NikkoLaw/CAD-KO1/Gewichtsberechnung.docx

Gewichtsberechnung

Gesamtgewciht= 22,383kg (<45kg)
