NikkoLaw/CAD-KO1/INHALTSVERZEICHNIS.docx

INHALTSVERZEICHNIS

Laufzettel

Handentwurf

Kinematik

Kräfteplan mit Kräfteberechnung

Festigkeitsnachweis der angegebenen kritischer Bauteilstellen

Werkstattzeichnung

Einzeilteilzeichnung (Hebel, Gestänge)

Stückliste

Datenblätter
