NikkoLaw/CAD-KO1/DRUCK 5.pdf

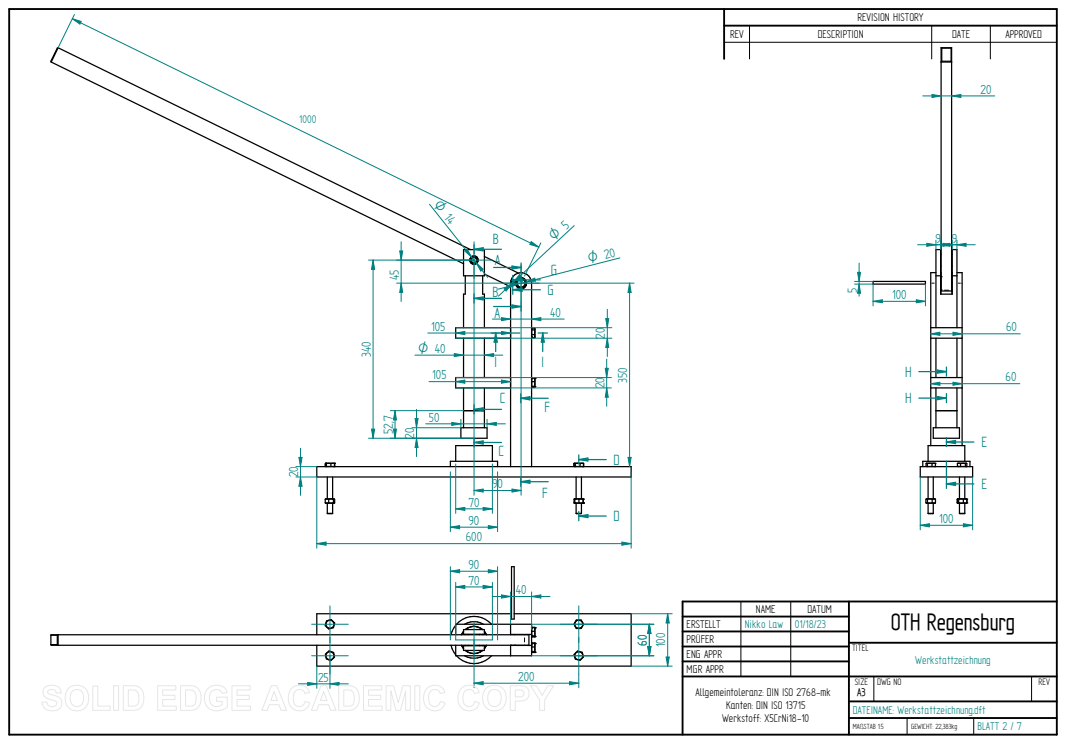
[picture p1: page 1]
TITEL; Werkstattzeichnung; MAßSTAB 1:5; GEWICHT: 22,383kg; BLATT 2 / 7

REVISION HISTORY

REV | DESCRIPTION | DATE | APPROVED

NAME | DATUM | OTH Regensburg

ERSTELLT | Nikko Law | 01/18/23
PRÜFER
ENG APPR
MGR APPR
Allgemeintoleranz: DIN ISO 2768-mk Kanten: DIN ISO 13715 Werkstoff: X5CrNi18-10 | SIZE A3 | DWG NO | REV

DATEINAME: Werkstattzeichnung.dft
