NikkoLaw/CAD-KO1/DRUCK 1.pdf

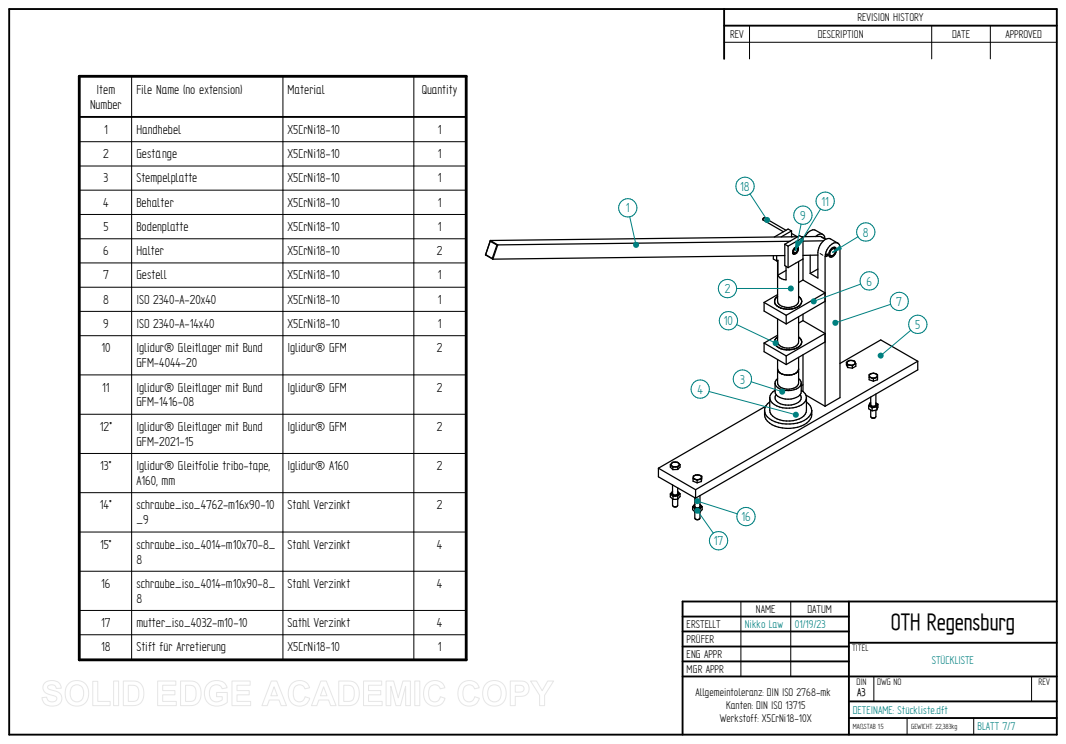
[picture p2: page 1]
TITEL; STÜCKLISTE; MAßSTAB 1:5; GEWICHT: 22,383kg; BLATT 7/7

REVISION HISTORY

REV | DESCRIPTION | DATE | APPROVED

Item Number | File Name (no extension) | Material | Quantity

1 | Handhebel | X5CrNi18-10 | 1
2 | Gestänge | X5CrNi18-10 | 1
3 | Stempelplatte | X5CrNi18-10 | 1
4 | Behalter | X5CrNi18-10 | 1
5 | Bodenplatte | X5CrNi18-10 | 1
6 | Halter | X5CrNi18-10 | 2
7 | Gestell | X5CrNi18-10 | 1
8 | ISO 2340-A-20x40 | X5CrNi18-10 | 1
9 | ISO 2340-A-14x40 | X5CrNi18-10 | 1
10 Iglidur® Gleitlager mit Bund | GFM-4044-20 | Iglidur® GFM | 2

11 Iglidur® Gleitlager mit Bund | GFM-1416-08 | Iglidur® GFM | 2

12* | Iglidur® Gleitlager mit Bund GFM-2021-15 | Iglidur® GFM | 2

13* | Iglidur® Gleitfolie tribo-tape, A160, mm | Iglidur® A160 | 2

14* | schraube_iso_4762-m16x90-10 _9 | Stahl Verzinkt | 2

15* | schraube_iso_4014-m10x70-8_ 8 | Stahl Verzinkt | 4

16 schraube_iso_4014-m10x90-8_ | 8 | Stahl Verzinkt | 4

NAME | DATUM | OTH Regensburg

17 | mutter_iso_4032-m10-10 | Sathl Verzinkt | 4
18 | Stift für Arretierung | X5CrNi18-10 | 1

ERSTELLT | Nikko Law | 01/19/23
PRÜFER
ENG APPR
MGR APPR
Allgemeintoleranz: DIN ISO 2768-mk Kanten: DIN ISO 13715 Werkstoff: X5CrNi18-10X | DIN A3 | DWG NO | REV

DETEINAME: Stückliste.dft
