NikkoLaw/CAD-KO1/DRUCK 2.pdf

40 | 35 12 | 14,51x45v
A

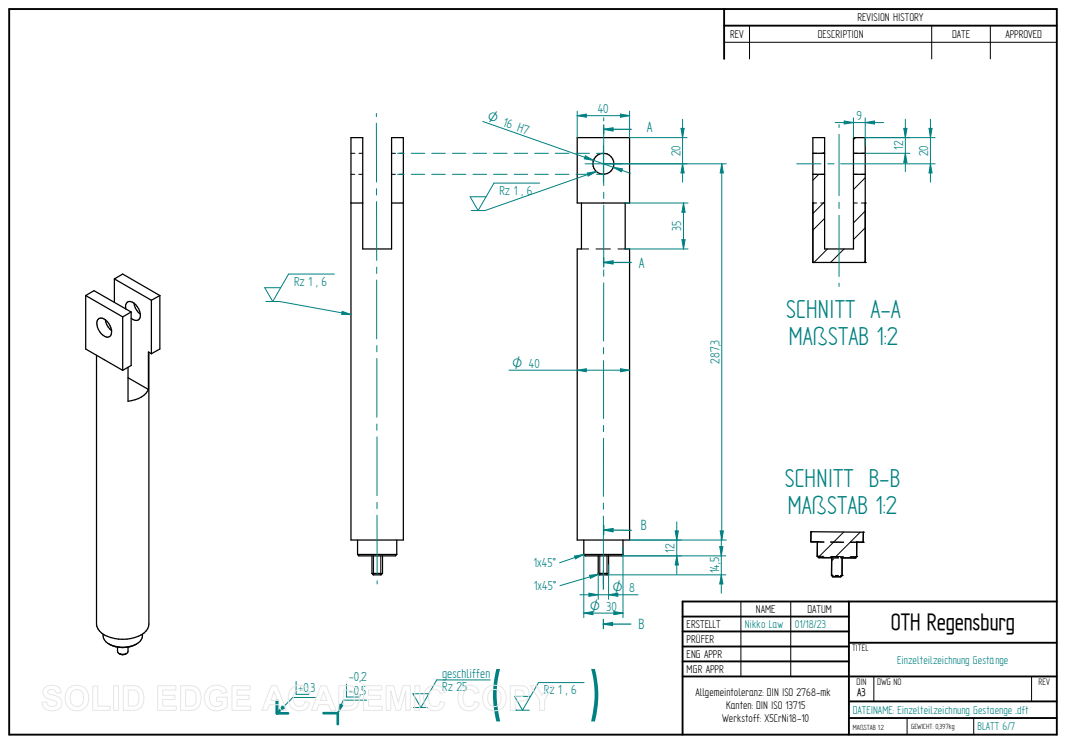
[picture p3: page 1]
TITEL; Einzelteilzeichnung Gestänge; MAßSTAB 1:2; GEWICHT: 0,397kg; BLATT 6/7; SCHNITT A-A MAßSTAB 1:2; SCHNITT B-B; MAßSTAB 1:2 ¹²; geschliffen

REVISION HISTORY

REV | DESCRIPTION | DATE | APPROVED

NAME | DATUM | OTH Regensburg

ERSTELLT | Nikko Law | 01/18/23
PRÜFER
ENG APPR
MGR APPR
Allgemeintoleranz: DIN ISO 2768-mk Kanten: DIN ISO 13715 Werkstoff: X5CrNi18-10 | DIN A3 | DWG NO | REV

DATEINAME: Einzelteilzeichnung Gestaenge .dft
