NikkoLaw/CAD-KO1/DRUCK 3.pdf

# SCHNITT A-A Maßstab 1:1

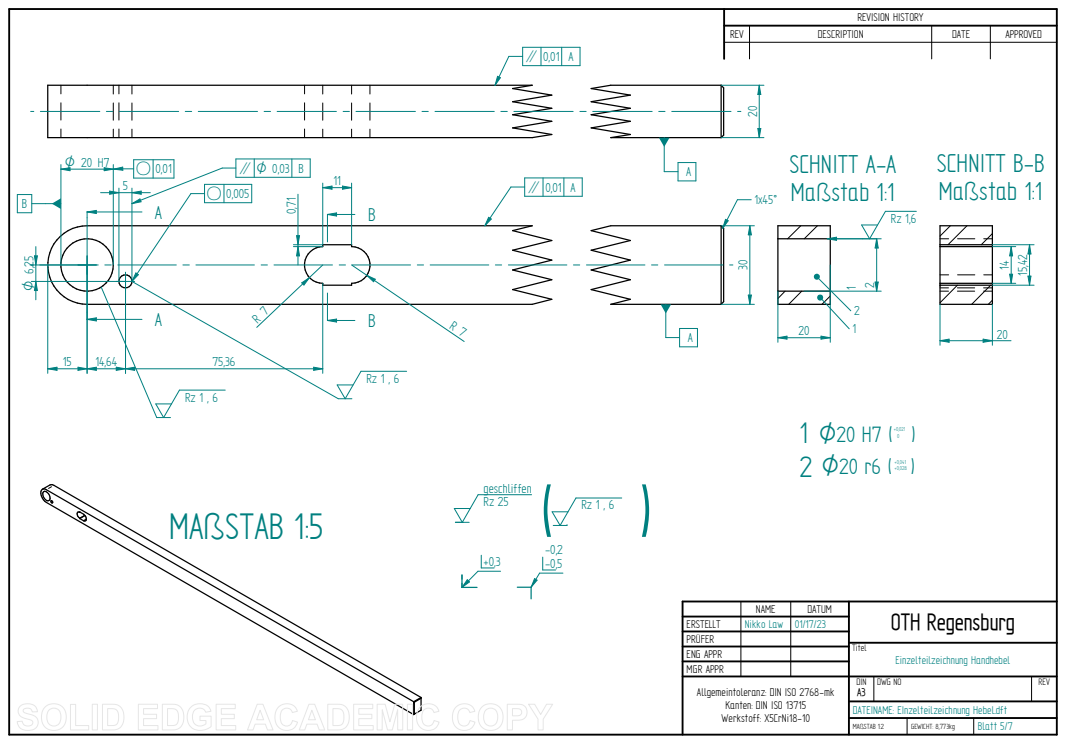
[picture p4: page 1]
Titel; Einzelteilzeichnung Handhebel; MAßSTAB 1:2; GEWICHT: 8,773kg; Blatt 5/7; MAßSTAB 1:5; SCHNITT B-B Maßstab 1:1

REVISION HISTORY

REV | DESCRIPTION | DATE | APPROVED

14,64 | A R 7 75,36 | geschliffen

NAME | DATUM | OTH Regensburg

ERSTELLT | Nikko Law | 01/17/23
PRÜFER
ENG APPR
MGR APPR
Allgemeintoleranz: DIN ISO 2768-mk Kanten: DIN ISO 13715 Werkstoff: X5CrNi18-10 | DIN A3 | DWG NO | REV

DATEINAME: EInzelteilzeichnung Hebel.dft
