NikkoLaw/CAD-KO1/DRUCK 4.pdf

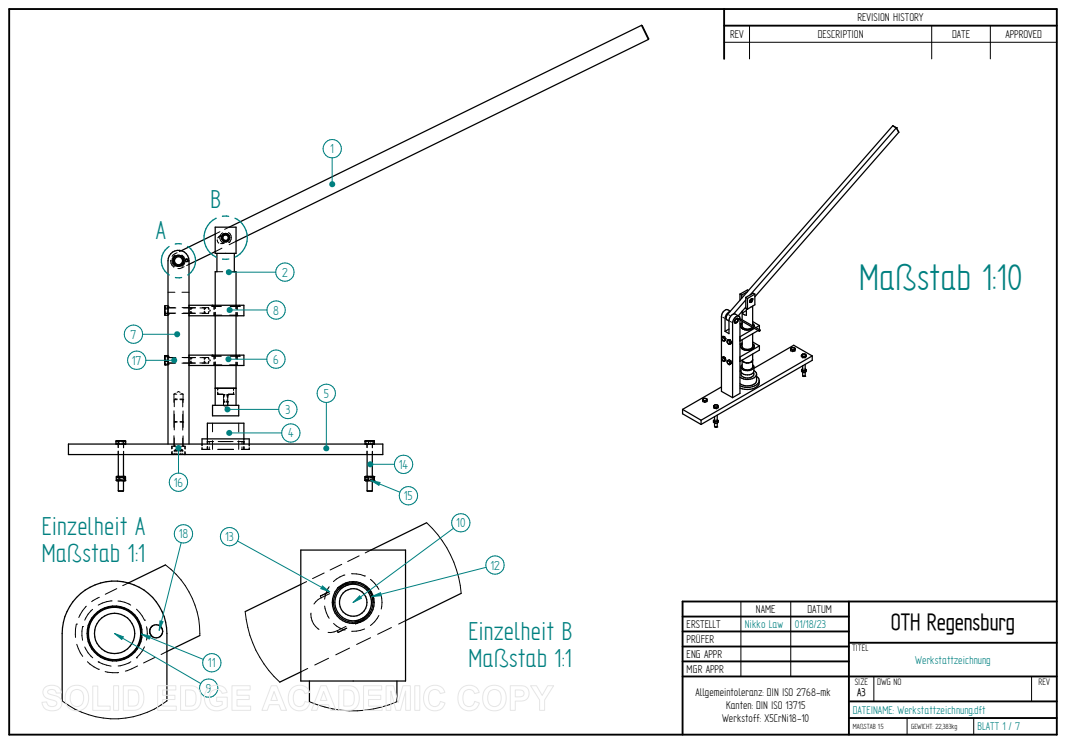
[picture p5: page 1]
TITEL; Werkstattzeichnung; MAßSTAB 1:5; GEWICHT: 22,383kg; BLATT 1 / 7; Einzelheit A Maßstab 1:1; Einzelheit B Maßstab 1:1; Maßstab 1:10

B | REVISION HISTORY

REV | DESCRIPTION | DATE | APPROVED

NAME | DATUM | OTH Regensburg

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

DATEINAME: Werkstattzeichnung.dft
