NikkoLaw/CAD-KO1/DRUCK 6.pdf

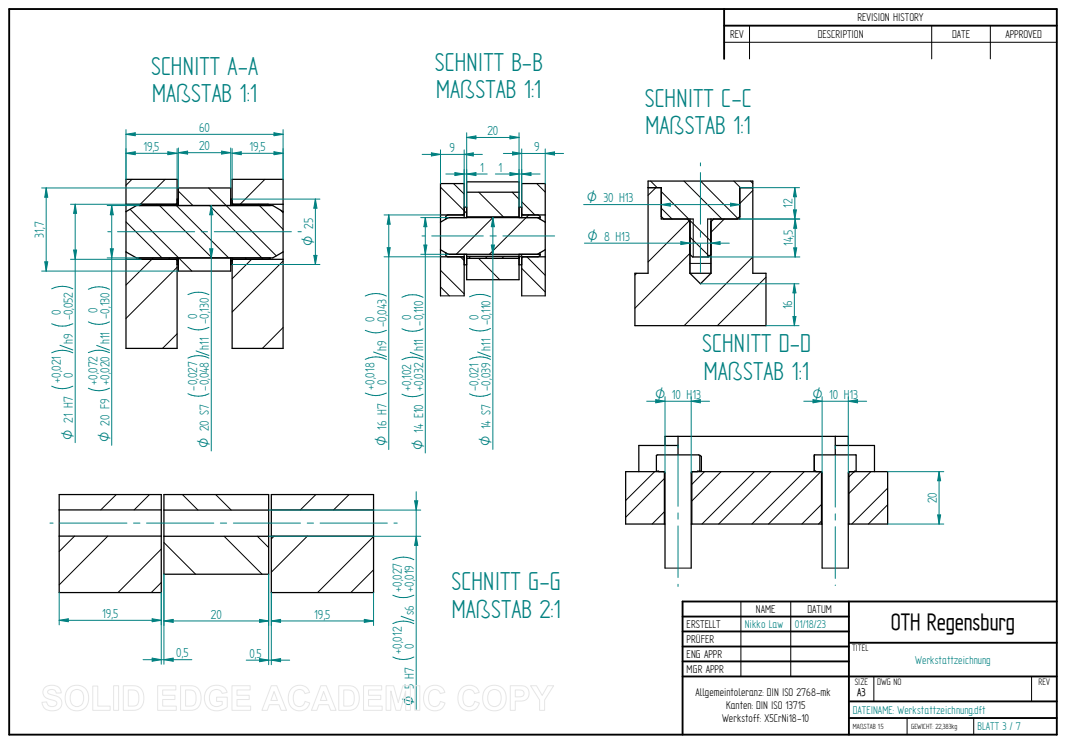
[picture p6: page 1]
TITEL; Werkstattzeichnung; MAßSTAB 1:5; GEWICHT: 22,383kg; BLATT 3 / 7; SCHNITT D-D MAßSTAB 1:1; MAßSTAB 1:1 20 h¹¹ 0-0,130 F9 +0,072 +0,020; SCHNITT G-G; MAßSTAB 2:1 5 s6 +0,027 +0,0¹9 H7 ⁺0,0¹2 0 O

SCHNITT B-B SCHNITT A-A MAßSTAB 1:1 SCHNITT C-C MAßSTAB 1:1 | REVISION HISTORY

REV | DESCRIPTION | DATE | APPROVED

NAME | DATUM | OTH Regensburg

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

DATEINAME: Werkstattzeichnung.dft
