NikkoLaw/CAD-KO1/DRUCK 7.pdf

# SCHNITT E-E

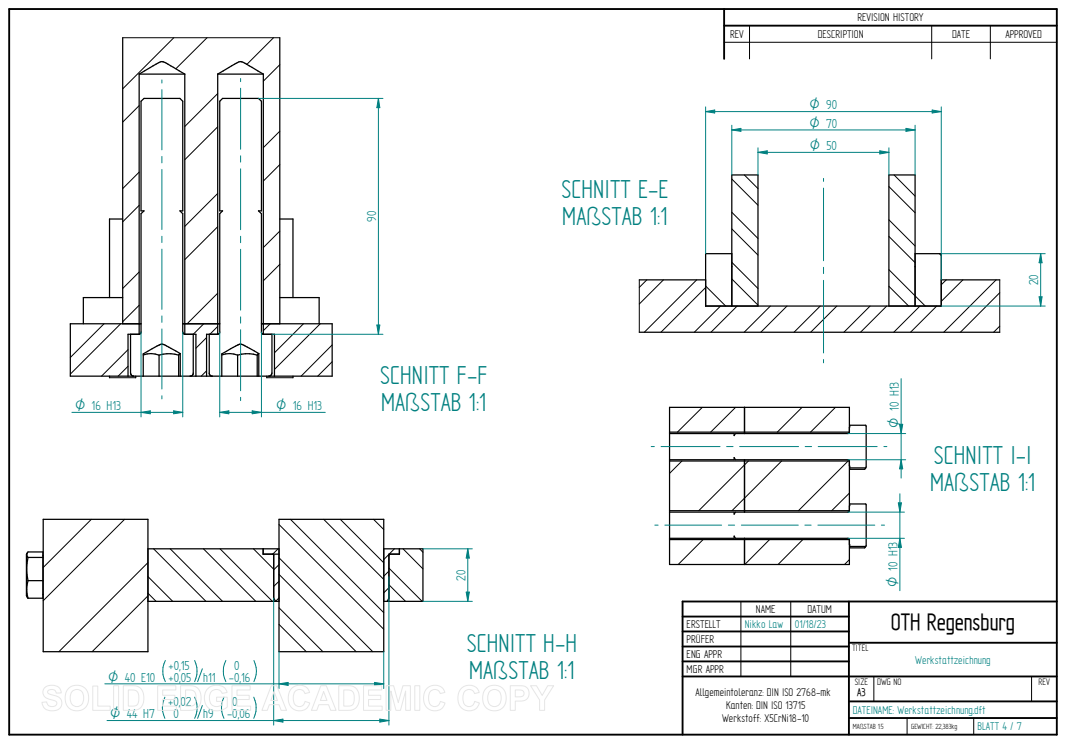
[picture p7: page 1]
ERSTELLT; NAME Nikko Law; DATUM; OTH Regensburg; TITEL; Werkstattzeichnung; MAßSTAB 1:5; GEWICHT: 22,383kg; BLATT 4 / 7; MAßSTAB 1:1; SCHNITT F-F; MAßSTAB 1:1 ⁹⁰; SCHNITT H-H MAßSTAB 1:1; SCHNITT I-I

REVISION HISTORY

REV | DESCRIPTION | DATE | APPROVED

MAßSTAB 1:1 ¹⁰ H¹³

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

DATEINAME: Werkstattzeichnung.dft
